Orizuro/pcbsoft/(list of files, drawings)

Other design files:
ADCS_Prototype (26-10-2026 23-57-21)/Public/Documents/Altium/ADCS_Prototype/ADCS_Prototype.PrjPcb
ADCS_Prototype (26-10-2026 23-57-21)/Public/Documents/Altium/ADCS_Prototype/Altium/1437566-3/1437566-3.PcbLib
ADCS_Prototype (26-10-2026 23-57-21)/Public/Documents/Altium/ADCS_Prototype/Altium/1437566-3/1437566-3.SchLib
ADCS_Prototype (26-10-2026 23-57-21)/Public/Documents/Altium/ADCS_Prototype/Altium/532610271/Altium/532610271/532610271.PcbLib
ADCS_Prototype (26-10-2026 23-57-21)/Public/Documents/Altium/ADCS_Prototype/Altium/532610271/Altium/532610271/532610271.SchLib
ADCS_Prototype (26-10-2026 23-57-21)/Public/Documents/Altium/ADCS_Prototype/Altium/ASM330LHHTR/ASM330LHHTR.PcbLib
ADCS_Prototype (26-10-2026 23-57-21)/Public/Documents/Altium/ADCS_Prototype/Altium/C1210C226J8RAC7800/C1210C226J8RAC7800.PcbLib
ADCS_Prototype (26-10-2026 23-57-21)/Public/Documents/Altium/ADCS_Prototype/Altium/C1210C226J8RAC7800/C1210C226J8RAC7800.SchLib
ADCS_Prototype (26-10-2026 23-57-21)/Public/Documents/Altium/ADCS_Prototype/Altium/CL05A105KO5NNNC/CL05A105KO5NNNC.PcbLib
ADCS_Prototype (26-10-2026 23-57-21)/Public/Documents/Altium/ADCS_Prototype/Altium/CL05A105KO5NNNC/CL05A105KO5NNNC.SchLib
ADCS_Prototype (26-10-2026 23-57-21)/Public/Documents/Altium/ADCS_Prototype/Altium/CL05B104KP5NNNC/CL05B104KP5NNNC.PcbLib
ADCS_Prototype (26-10-2026 23-57-21)/Public/Documents/Altium/ADCS_Prototype/Altium/CL05B104KP5NNNC/CL05B104KP5NNNC.SchLib
ADCS_Prototype (26-10-2026 23-57-21)/Public/Documents/Altium/ADCS_Prototype/Altium/ERJ-3EKF8062V/ERJ-3EKF8062V.PcbLib
ADCS_Prototype (26-10-2026 23-57-21)/Public/Documents/Altium/ADCS_Prototype/Altium/ERJ-3EKF8062V/ERJ-3EKF8062V.SchLib
ADCS_Prototype (26-10-2026 23-57-21)/Public/Documents/Altium/ADCS_Prototype/Altium/ERJ-6ENF2260V/ERJ-6ENF2260V.PcbLib
ADCS_Prototype (26-10-2026 23-57-21)/Public/Documents/Altium/ADCS_Prototype/Altium/ERJ-6ENF2260V/ERJ-6ENF2260V.SchLib
ADCS_Prototype (26-10-2026 23-57-21)/Public/Documents/Altium/ADCS_Prototype/Altium/KDV06FR100ET/KDV06FR100ET.PcbLib
ADCS_Prototype (26-10-2026 23-57-21)/Public/Documents/Altium/ADCS_Prototype/Altium/KDV06FR100ET/KDV06FR100ET.SchLib
ADCS_Prototype (26-10-2026 23-57-21)/Public/Documents/Altium/ADCS_Prototype/Altium/MP6519GQ-Z/MP6519GQ-Z.PcbLib
ADCS_Prototype (26-10-2026 23-57-21)/Public/Documents/Altium/ADCS_Prototype/Altium/MP6519GQ-Z/MP6519GQ-Z.SchLib
ADCS_Prototype (26-10-2026 23-57-21)/Public/Documents/Altium/ADCS_Prototype/CAN.SchDoc
ADCS_Prototype (26-10-2026 23-57-21)/Public/Documents/Altium/ADCS_Prototype/Complete circuit.SchDoc
ADCS_Prototype (26-10-2026 23-57-21)/Public/Documents/Altium/ADCS_Prototype/Connectors.SchDoc
ADCS_Prototype (26-10-2026 23-57-21)/Public/Documents/Altium/ADCS_Prototype/Control_Board.PcbDoc
ADCS_Prototype (26-10-2026 23-57-21)/Public/Documents/Altium/ADCS_Prototype/Conversion3V3.SchDoc
ADCS_Prototype (26-10-2026 23-57-21)/Public/Documents/Altium/ADCS_Prototype/Conversion5V.SchDoc
ADCS_Prototype (26-10-2026 23-57-21)/Public/Documents/Altium/ADCS_Prototype/CurrentSensing.SchDoc
ADCS_Prototype (26-10-2026 23-57-21)/Public/Documents/Altium/ADCS_Prototype/Filters.SchDoc
ADCS_Prototype (26-10-2026 23-57-21)/Public/Documents/Altium/ADCS_Prototype/Memory.SchDoc
ADCS_Prototype (26-10-2026 23-57-21)/Public/Documents/Altium/ADCS_Prototype/Sensors.SchDoc
ADCS_Prototype (26-10-2026 23-57-21)/Public/Documents/Altium/OBC_Prototype_Mk3/RM3100_W.PcbLib
