Orizuro/pcbsoft/(commit log)

2026-11-05 Initial commit: ADCS peripheral bring-up firmware and Altium project
    main.c tests the magnetometer (RM3100), IMU (ASM330LHHTR) and MRAM
    (MR25H40) over their own SPI buses on a PIC32MZ2048EFM100. Includes
    fixes found during bring-up on real hardware via PICkit5/MPLAB X:
    TRISx direction bits for SCK/MOSI pins, and ANSELx analog-mode bits
    on SPI2/SPI3 pins that double as ADC channels. MRAM is confirmed
    working end-to-end; magnetometer and IMU still read 0x00, currently
    suspected to be insufficient current from PICkit5 tool-power when
    all three sensor rails are enabled simultaneously.
    [1437566-3.PcbLib, 1437566-3.SchLib, 532610271.PcbLib, 532610271.SchLib, ADCS_Prototype.PrjPcb, ASM330LHHTR.PcbLib, C1210C226J8RAC7800.PcbLib, C1210C226J8RAC7800.SchLib]
2026-11-05 Add pcbsoft.X MPLAB X project (classic IDE project used for bring-up)
    This is the actual MPLAB X IDE project used to debug/program the
    board during bring-up, consolidated into this repo so it travels
    together with the firmware source and Altium design. Device:
    PIC32MZ2048EFM100, XC32 v6.00, PIC32MZ-EF_DFP 1.6.179.
    nbproject/private/, build/, debug/, dist/ etc. are gitignored
    (machine-local settings and regenerated build output).
